google/calliope-paper-robot/README.md

# 🤖 Calliope Paper Robot

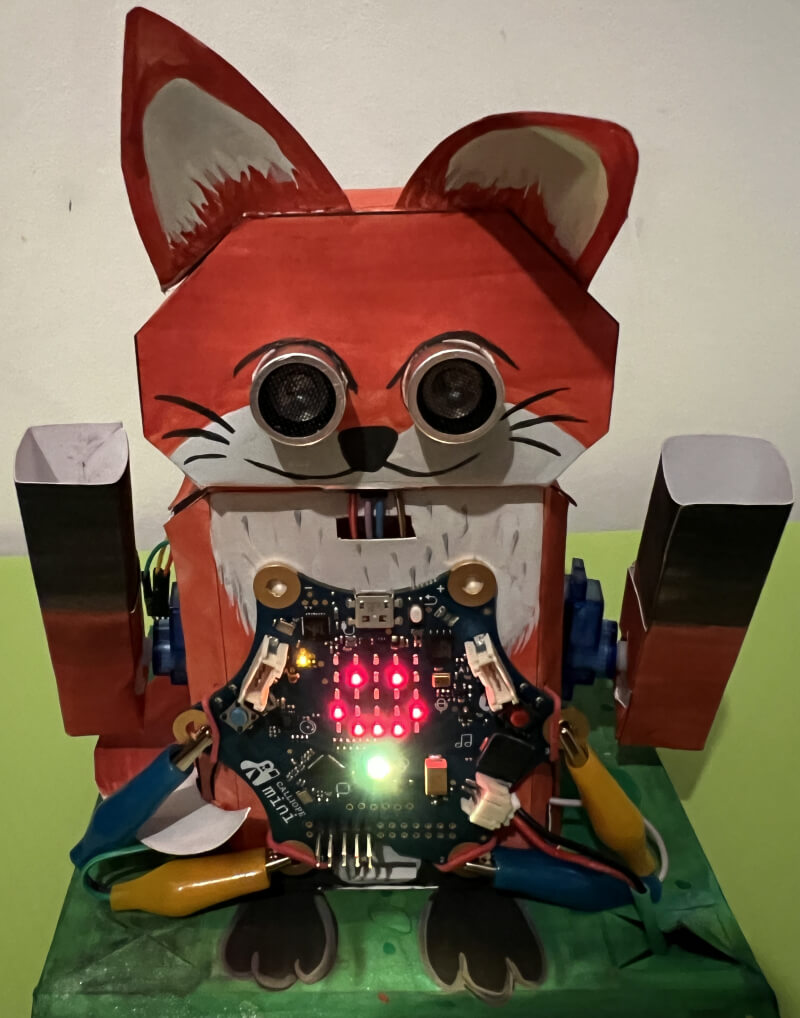
[picture p1: paper_robot/paper_robot_colored.jpg]
Example of paper robot


This open source project provides an easy to build and easy to setup paper robot for the [Calliope Mini][calliope_mini] board.
It includes basic examples how to use the [Calliope Mini][calliope_mini], details on using additional hardware and advanced examples to program the robot with the [Open Roberta Lab][open_roberta_lab].

## 📚 Content

The content is separated in three different main areas to cover different kind of skill levels from beginners to more advanced users.

### ⚙️ **Calliope Mini**

This area covers the basic around the Calliope Mini and the built in sensors and actors.
It's mandatory to understand the basics before moving to the other more advanced parts.

- [Overview / Board](calliope_mini/board/README.md)
  - LCD Screen
  - Speaker
  - RGB-LED
  - Position Sensor
  - Button A/B
  - Pins

### 🦾 **Hardware**

This area covers any special or additional hardware for the Calliope Mini.

- Battery Box
  - [Battery Box with 3v and 4.5v](hardware/battery_box/README.md)
  - [Battery Box with 3v and 4.5v and Connectors](hardware/battery_box_advanced/README.md)
- [Ultrasonic HC-SR04](hardware/ultrasonic_hc-sr04/README.md)
- [Micro Servo 9g SG90](hardware/micro_servo_sg90/README.md)

### 🤖 **Paper Robot**

This area covers the paper robot and how the different parts will work together.
After following these steps you will have great foundation for most of the public available examples and projects for your Calliope Mini.

- [Paper Robot](paper_robot/README.md)
  - [Base](paper_robot/base/README.md)
  - [Body](paper_robot/body/README.md)
  - [Head](paper_robot/head/README.md)
  - [Arms](paper_robot/arms/README.md)

## 🧩 Status

Currently in development.

## 📜 Licensing

Apache License, Version 2.0 see [LICENSE.md](LICENSE.md)

## 🤝 Contributing

Contributing to this project is subject to the guidelines in the
[CONTRIBUTING.md](CONTRIBUTING.md) file, which, in brief, requires that
contributors sign the [Individual Contributor License Agreement (CLA)][cla].

[calliope_mini]: https://calliope.cc/
[cla]: https://cla.developers.google.com/
[open_roberta_lab]: https://lab.open-roberta.org/
