google/calliope-paper-robot/paper_robot/base/README.md

# Paper Robot - Base

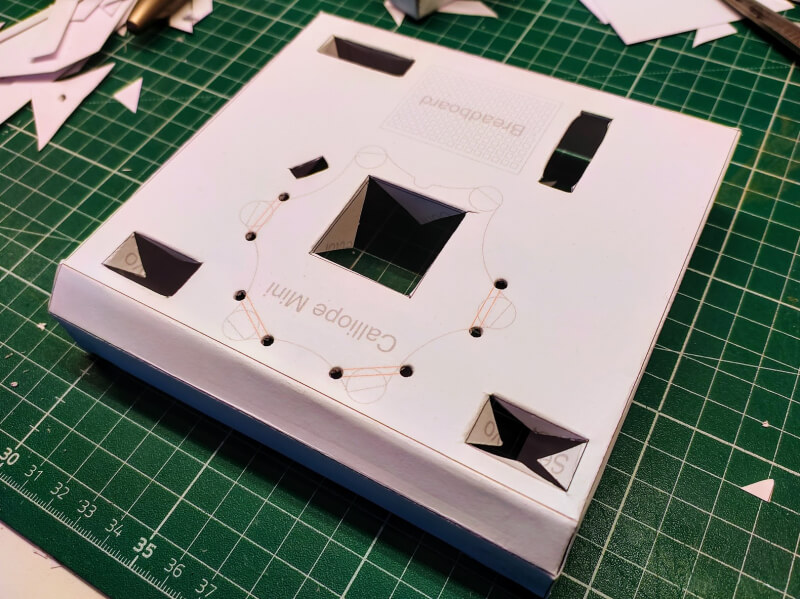
[picture p8: paper_robot/base/paper_robot_base.jpg]
Example of paper robot base


## Papercraft

The average building time for cutting, bending and glueing will take about 25min.

📄 [Paper Bot - Base v2.pdf](papercraft/Paper%20Bot%20-%20Base%20v2.pdf)

## Testing

The base is ideal for testing your components and your program before moving to the final assembly.

You could easily place the breadboard, ultrasonic sensor and the servos together with the Calliope Mini Board for testing.

Example of paper robot base for testing

## Connection Pins

The following pins are used for the different kind of sensors and actors.

| Name | Device Pin | Calliope Mini Pin | Battery Pack |
| --- | --- | --- | --- |
| Micro Servo SG90 (left)  | GND ⏚ | - | GND ⏚ |
| Micro Servo SG90 (left)  | SIGNAL 🦾  | P1 /C1 🟠 | - |
| Micro Servo SG90 (left)  | VCC ⚡ | - | 5V ⚡ |
| Micro Servo SG90 (right) | GND ⏚ | - | GND ⏚ |
| Micro Servo SG90 (right) | SIGNAL 🦾  | P2 /C2 🟠 | - |
| Micro Servo SG90 (right) | VCC⚡ | - | 5V ⚡ |
| Ultrasonic HC SR04 | GND ⏚ | - | GND ⏚ |
| Ultrasonic HC SR04 | TRIG 🕪 | P0 /C0 🟡 | - |
| Ultrasonic HC SR04 | ECHO 🎤 | P3 /C3 🟢 | - |
| Ultrasonic HC SR04 | VCC ⚡ | - | 5V ⚡ |

## Wiring

For wiring the different kind of connection, the following is recommend.

### Micro Servos SG90 wiring

Example wiring for the micro servo SG90 with contact pins or pin headers.

#### Micro Servos SG90 wiring with contact pins

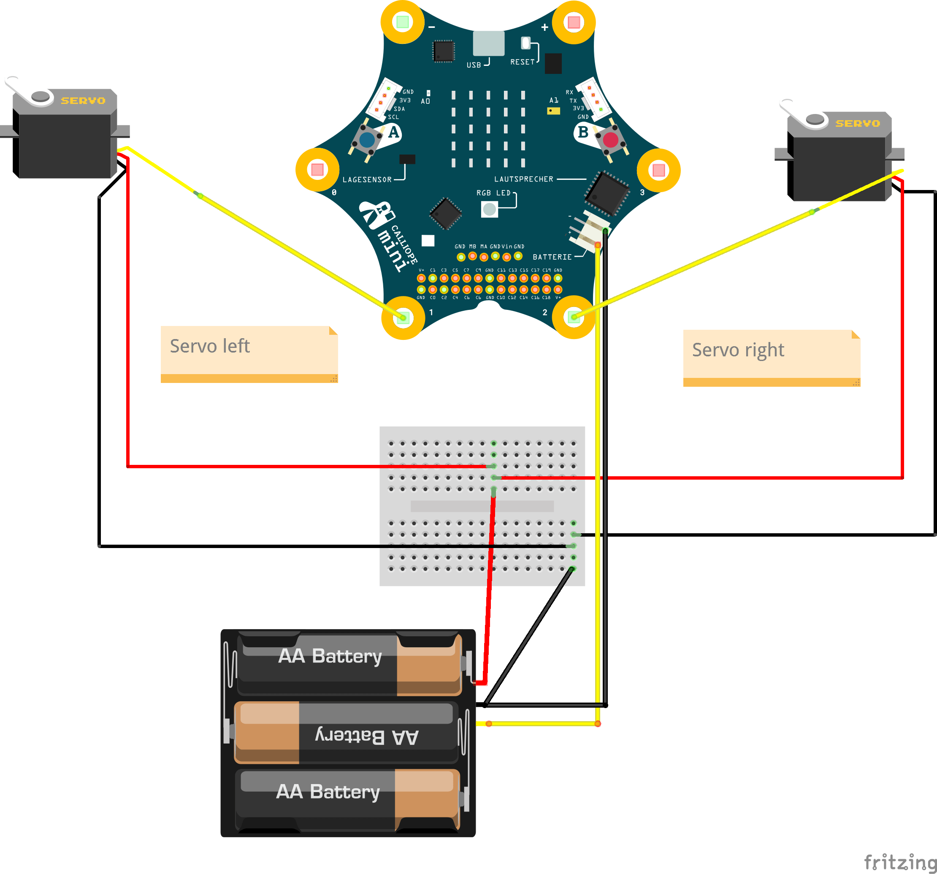
[picture p9: paper_robot/fritzing/servo_wiring.png]
Example of servo wiring


#### Micro Servos SG90 wiring with pin header

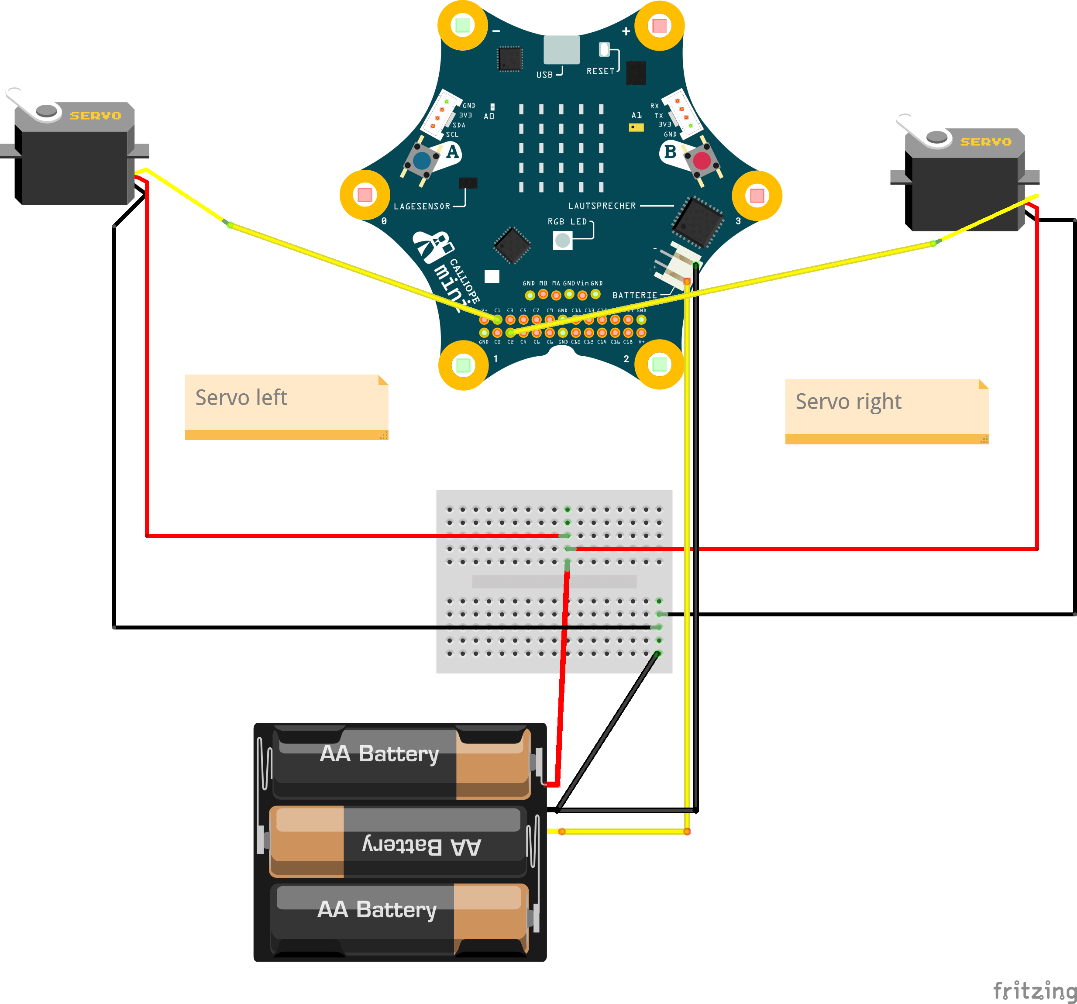
[picture p10: paper_robot/fritzing/servo_wiring_pin_header.png]
Example of servo wiring with pin header


### Ultra Sonic HC-SRC04 wiring

Example wiring for the ultra sonic HC-SRC04 sensor with contact pins or pin headers.

#### Ultra Sonic HC-SRC04 wiring with contact pins

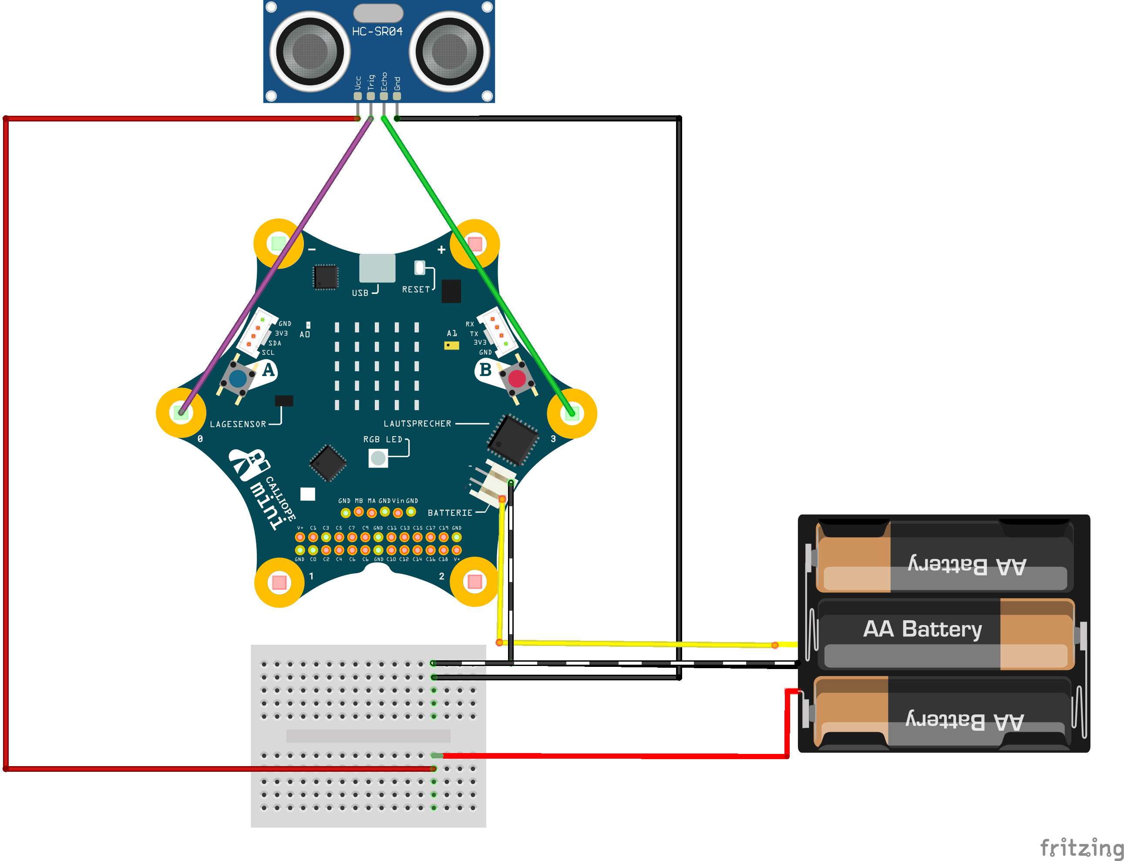
[picture p11: paper_robot/fritzing/ultrasonic_wiring.png]
Example of ultra sonic wiring


#### Ultra Sonic HC-SRC04 wiring with pin header

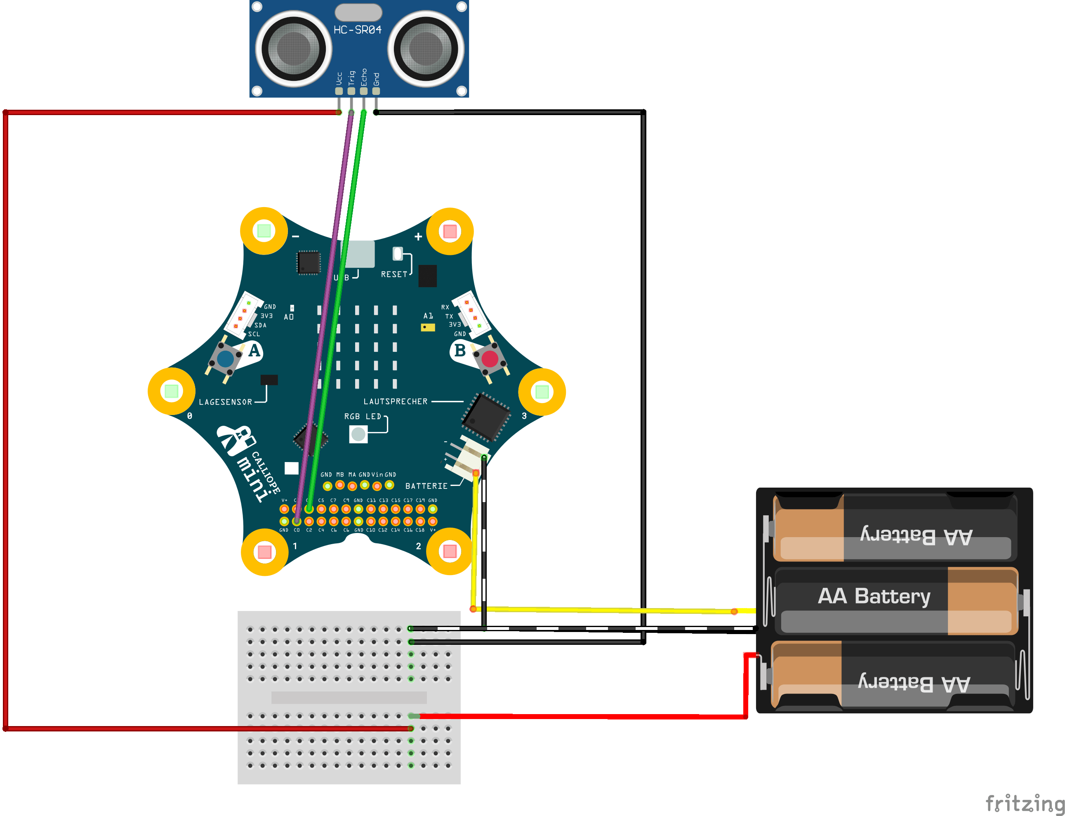
[picture p12: paper_robot/fritzing/ultrasonic_wiring_pin_header.png]
Example of ultra sonic wiring


### Micro Servos SG90 and Ultra Sonic HC-SRC04 wiring

Example wiring for the micro servo SG90 and ultra sonic HC-SRC04 sensor with contact pins or pin headers.

#### Micro Servos SG90 and Ultra Sonic HC-SRC04 wiring with contact pins

Example of servo and ultra sonic wiring

#### Micro Servos SG90 and Ultra Sonic HC-SRC04 wiring with pin header

Example of servo and ultra sonic wiring

## Example Program / Test Program

### Configuration

For the example program we are using the following robot configuration.

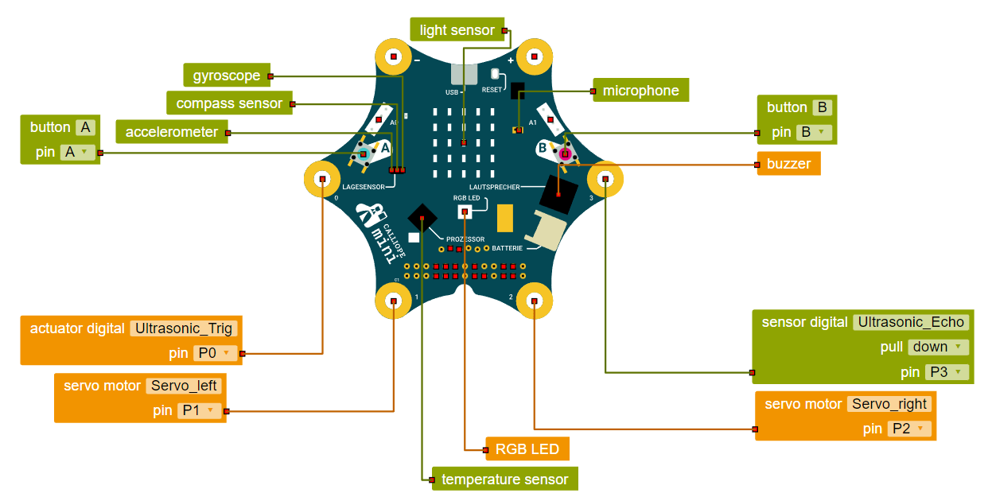
[picture p13: paper_robot/base/images/example_test_configuration.png]
Example test configuration


### Program

The following program could be used for a simple test to see if everything works correct.

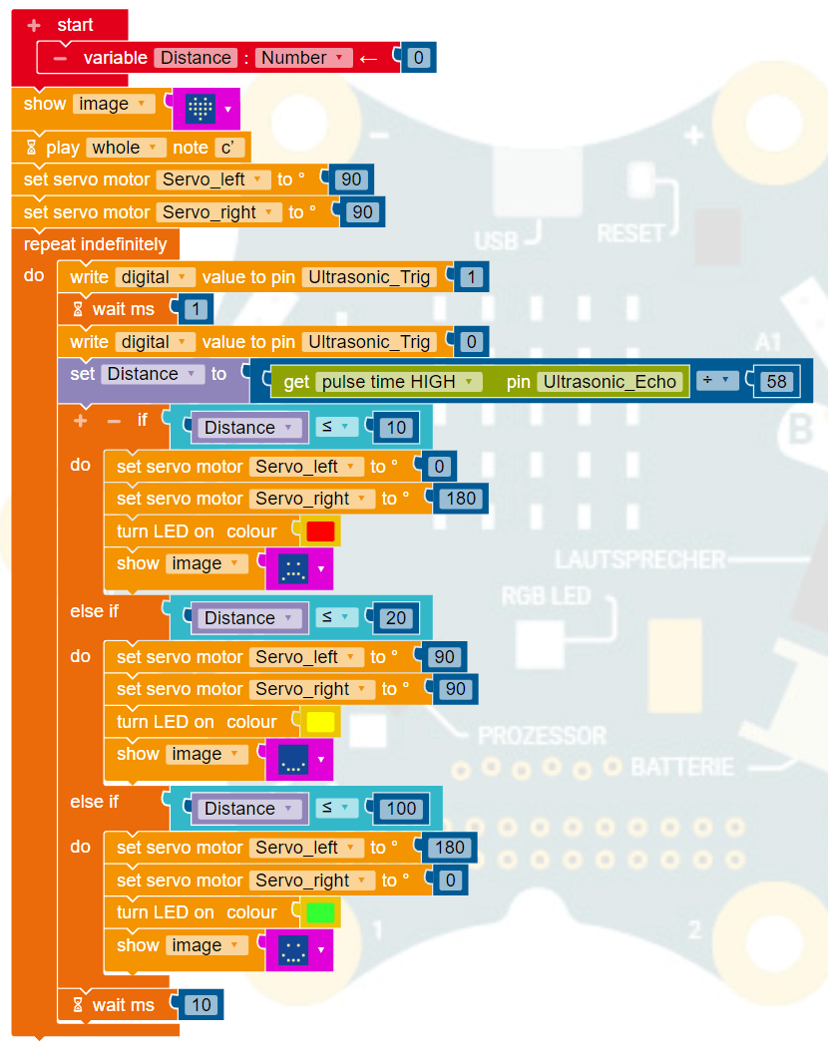
[picture p14: paper_robot/base/images/example_test_program.png]
Example test program
