google/calliope-paper-robot/paper_robot/arms/README.md

# Paper Robot - Arms

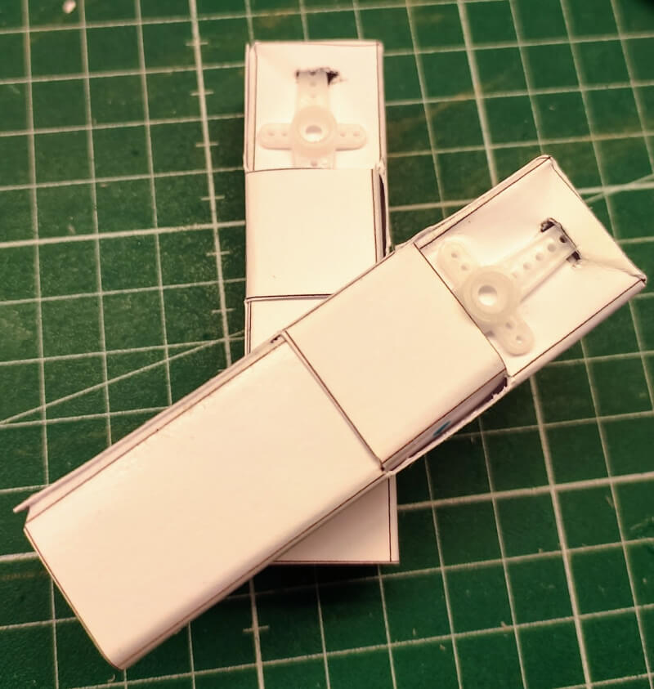
[picture p26: paper_robot/arms/paper_robot_arms.jpg]
Example of paper robot arms


## Papercraft

The average building time for cutting, bending and glueing will take about 15min.

📄 [Paper Bot - Arms v2.pdf](papercraft/Paper%20Bot%20-%20Arms%20v2.pdf)

## Usage

The arms should be assembled and attached as last part, to make sure that the robot is not destroying himself.
