google/calliope-paper-robot/paper_robot/body/README.md

# Paper Robot - Body

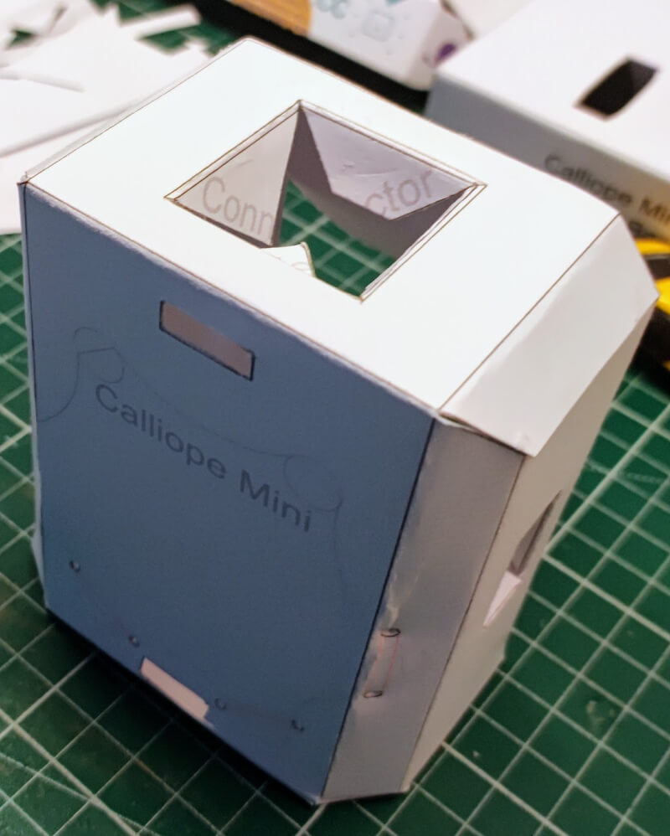
[picture p47: paper_robot/body/paper_robot_body.jpg]
Example of paper robot body


## Papercraft

The average building time for cutting, bending and glueing will take about 25min.

📄 [Paper Bot - Body v2.pdf](papercraft/Paper%20Bot%20-%20Body%20v2.pdf)
