google/calliope-paper-robot/paper_robot/head/README.md

# Paper Robot - Head

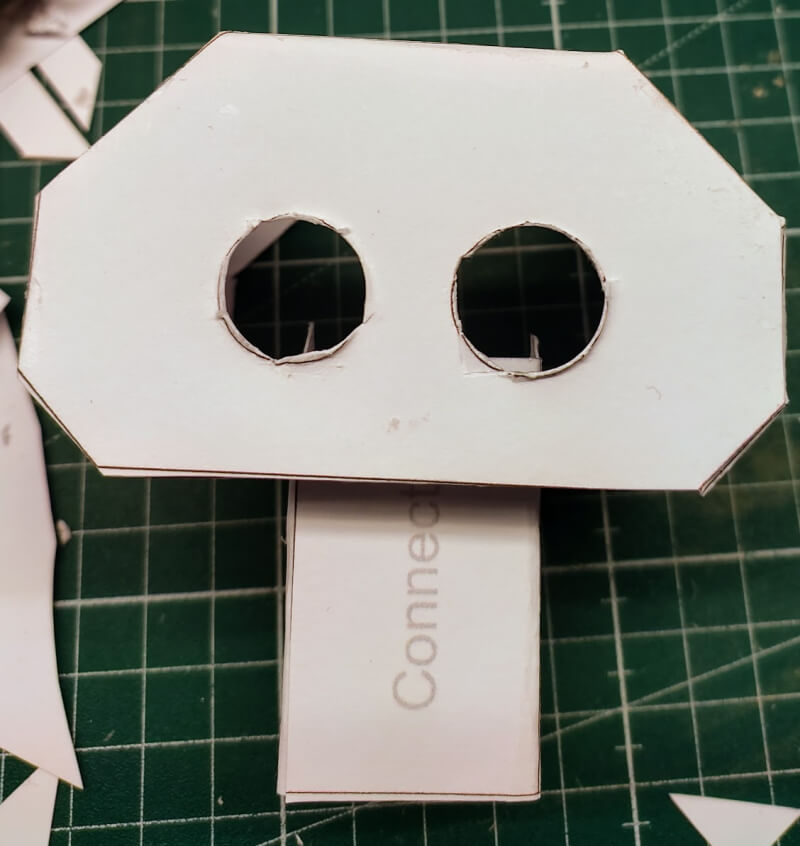
[picture p48: paper_robot/head/paper_robot_head.jpg]
Example of paper robot head


## Papercraft

The average building time for cutting, bending and glueing will take about 25min.

📄 [Paper Bot - Head v2.pdf](papercraft/Paper%20Bot%20-%20Head%20v2.pdf)
