google/calliope-paper-robot/paper_robot/arms/papercraft/Paper Bot - Arms v2.pdf

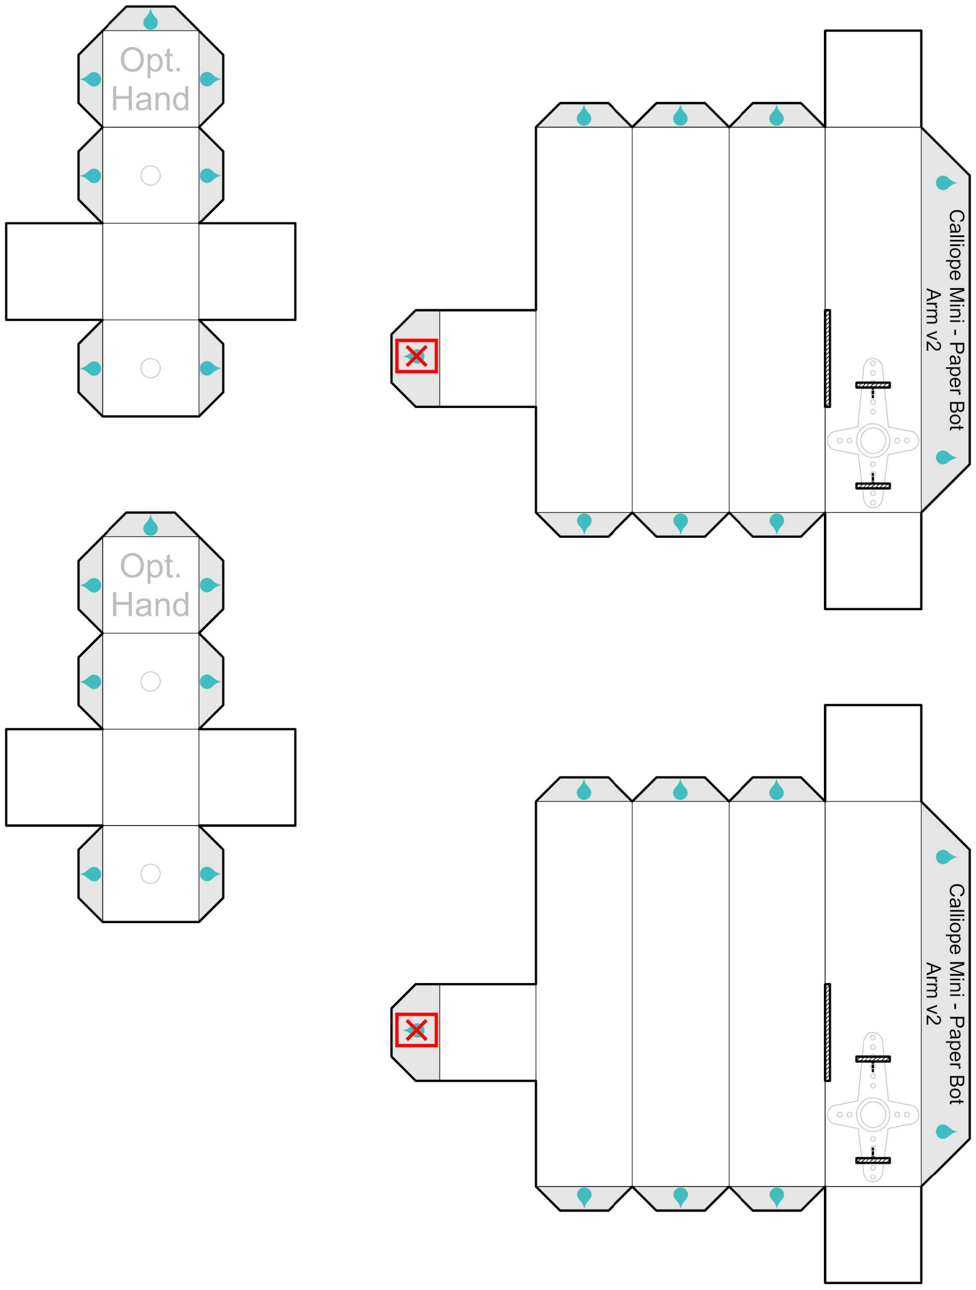
[picture p92: page 1]
