google/calliope-paper-robot/paper_robot/base/papercraft/Paper Bot - Base v2.pdf

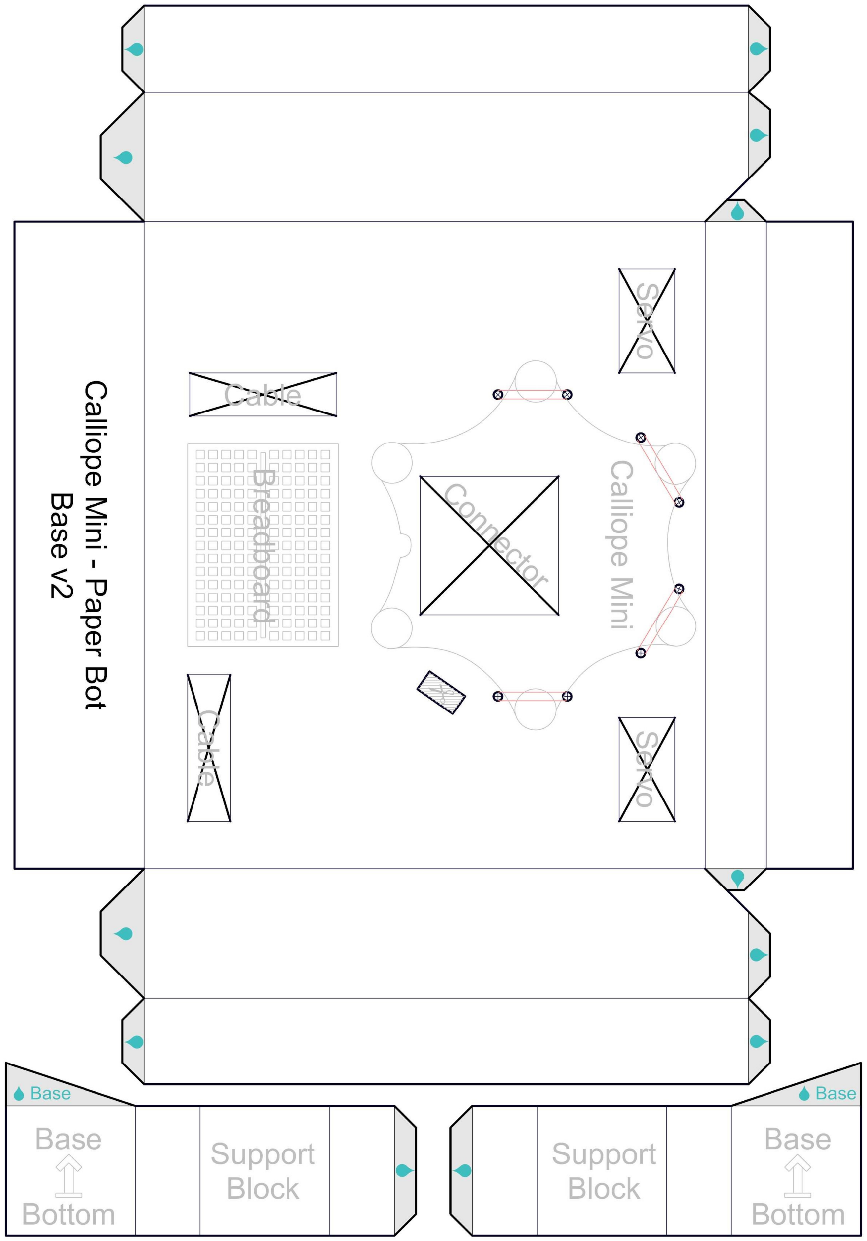
[picture p93: page 1]
