google/calliope-paper-robot/paper_robot/body/papercraft/Paper Bot - Body v2.pdf

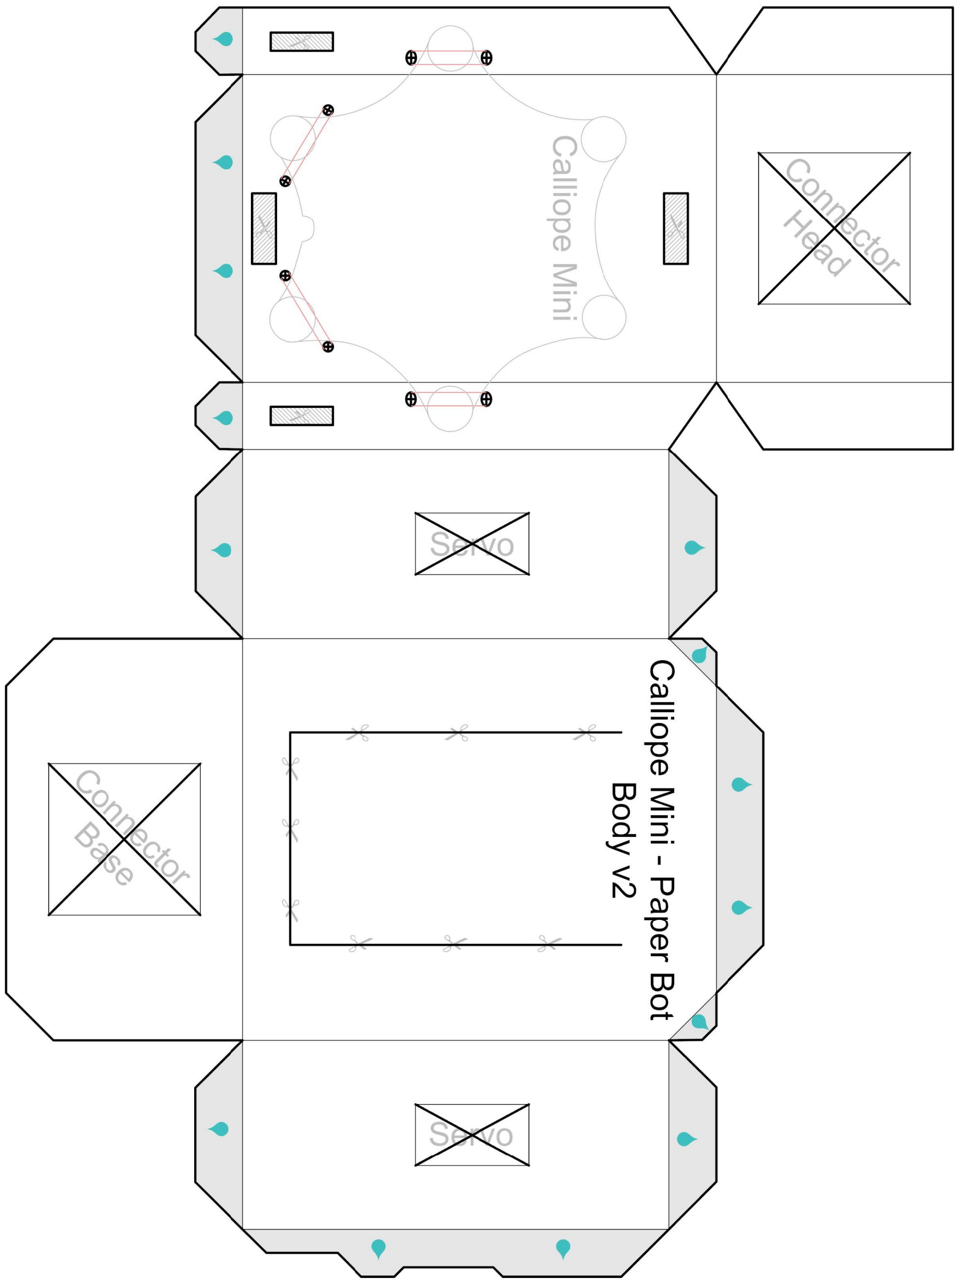
[picture p94: page 1]
