google/calliope-paper-robot/paper_robot/head/papercraft/Paper Bot - Head v2.pdf

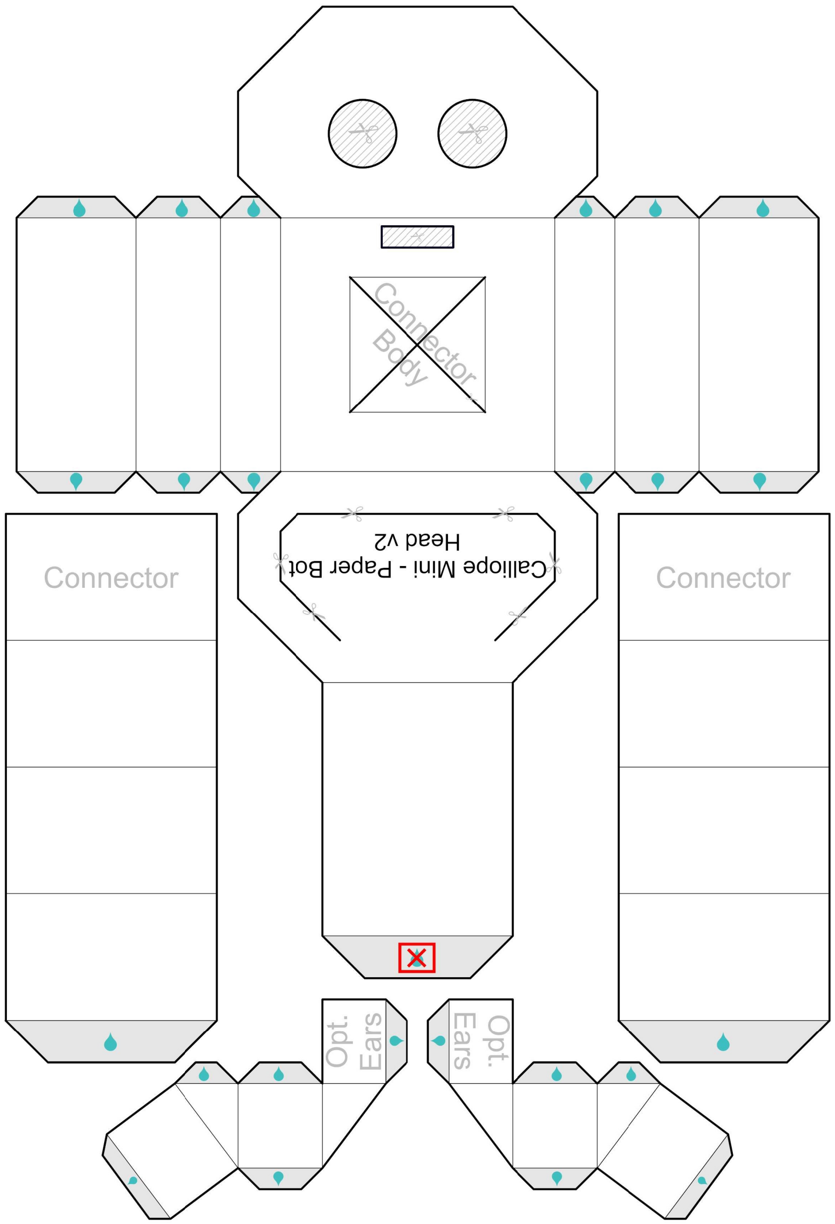
[picture p95: page 1]
