google/calliope-paper-robot/paper_robot/paper_robot.jpg

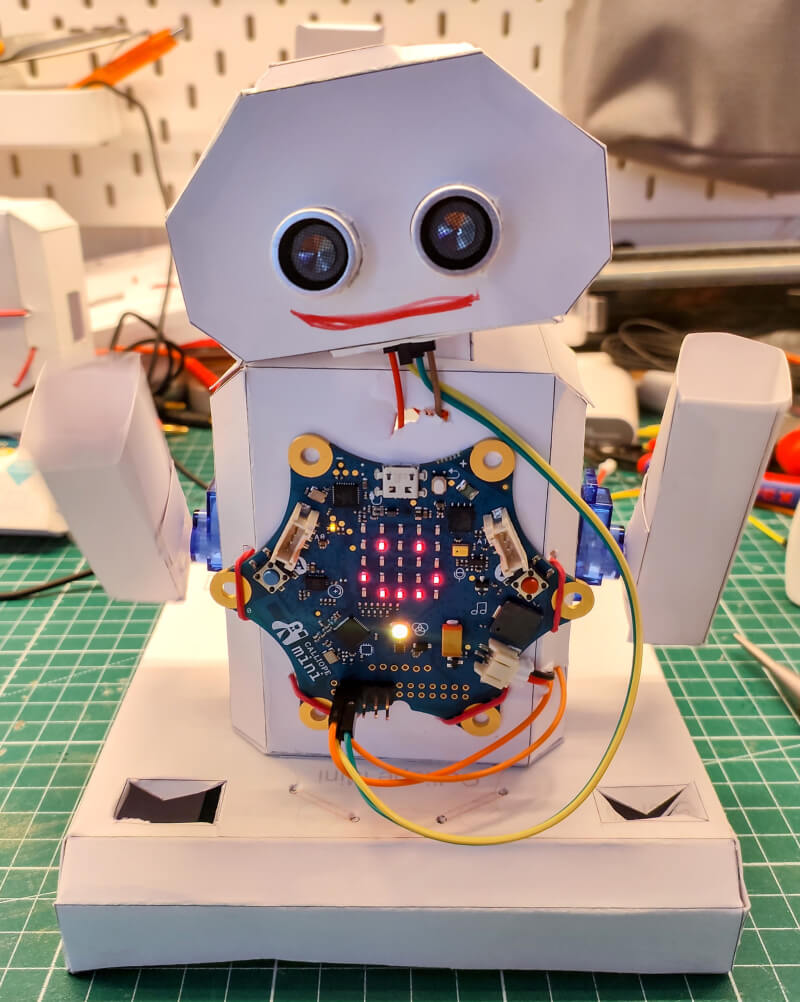
paper_robot/paper_robot.jpg
