google/calliope-paper-robot/(threads)

Thread 1 (2023-01-05):

Using grove port for servos

rbtnx, 2023-01-05:
Small idea for improving/simplifying the wiring: You can use the grove port A1 to connect two servos using the C16 and C17 pins. You can use a grove cable and male jumper cables to connect the servo or prepare cables by cutting a grove cable and soldering male headers for the servos. Alternatively you can use a semi-professional solution like this [servo board](https://upverter.com/design/mkleinsb/a0514ad5a36d465d/servoboard-v18-smd) by Martin Klein. It also powers the servos with 5 V instead of 3.3 V.

I just came across your paper robot and I love it! I built a similar one based on this [ticklebot](https://www.jasmineflorentine.com/ticklebot) and I'd love to try it in one of my courses with kids.
