google/calliope-paper-robot/(list of files, drawings)

Other design files:
paper_robot/fritzing/servo_and_ultrasonic_wiring.fzz
paper_robot/fritzing/servo_and_ultrasonic_wiring_pin_header.fzz
paper_robot/fritzing/servo_wiring.fzz
paper_robot/fritzing/servo_wiring_pin_header.fzz
paper_robot/fritzing/ultrasonic_wiring.fzz
paper_robot/fritzing/ultrasonic_wiring_pin_header.fzz
