google/calliope-paper-robot/(commit log)

2022-09-05 Added basic structure and battery box tutorial.
2022-09-08 Added ultra sonic HC-SR04 sensor tutorial.
2022-09-08 Added switch LED matrix block to ultra sonic example to avoid screen flickering.
2022-09-15 Added board overview and example board images.
2022-09-20 Added micro servo sg90 example. Added general material overview for the paper bot. Improved existing documentation.
2022-09-23 Added additional example images. Added basis example test program. Added sensor and actor pin overview with connection pin.
2022-09-25 Added advanced battery box version. Added pin connection plan for better overview.
    [base_servo_and_ultrasonic_wiring.fzz, base_servo_and_ultrasonic_wiring_pin_header.fzz, base_servo_wiring.fzz, base_ultrasonic_wiring.fzz]
2022-09-25 Updated papercraft templates with better glueability.
2022-09-28 Updated wiring examples and added pin header versions.
    [base_servo_and_ultrasonic_wiring.fzz, base_servo_and_ultrasonic_wiring_pin_header.fzz, base_servo_wiring.fzz, base_ultrasonic_wiring.fzz, servo_and_ultrasonic_wiring.fzz, servo_and_ultrasonic_wiring_pin_header.fzz, servo_wiring.fzz, servo_wiring_pin_header.fzz]
